ampxtreme/Gruppe-2---Mars-Rover-Challenge/Software/Test/README.md

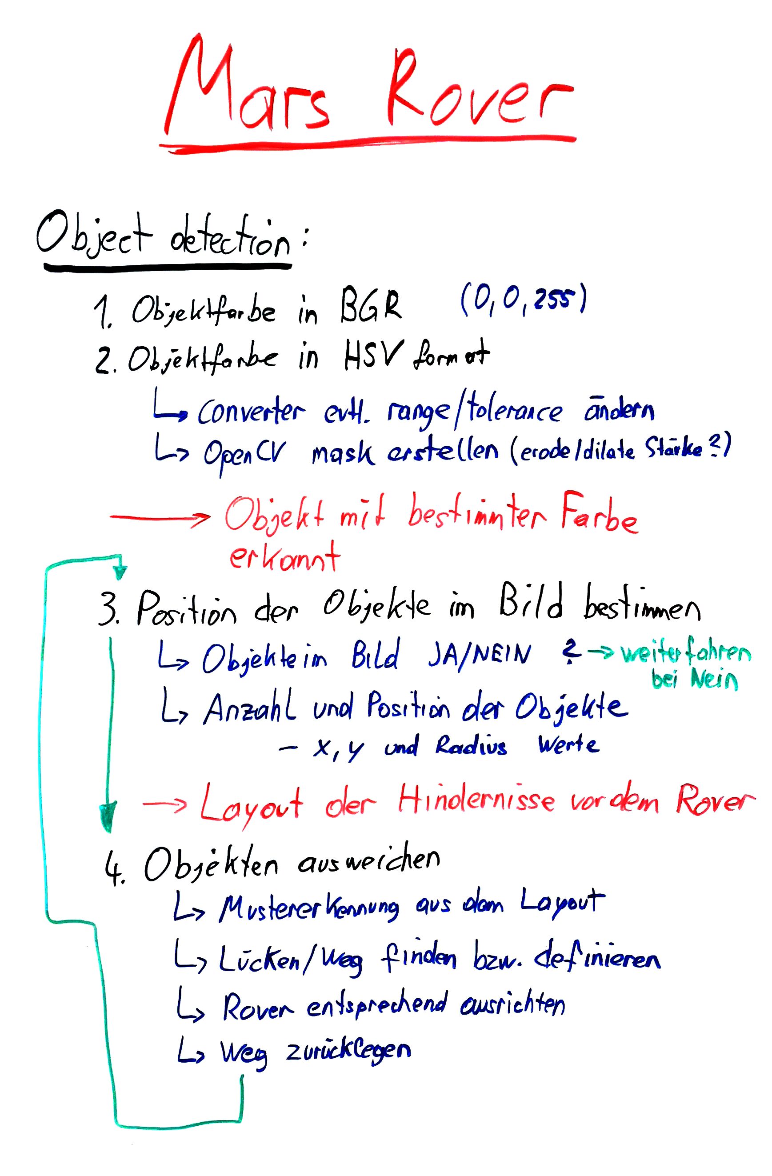
[picture p1: Software/Objekterkennung/objekterkennung_programm.jpg]
Objekterkennung Programmaufbau
