ampxtreme/Gruppe-2---Mars-Rover-Challenge/Dokumentation/Bilder/20190126_115140.jpg

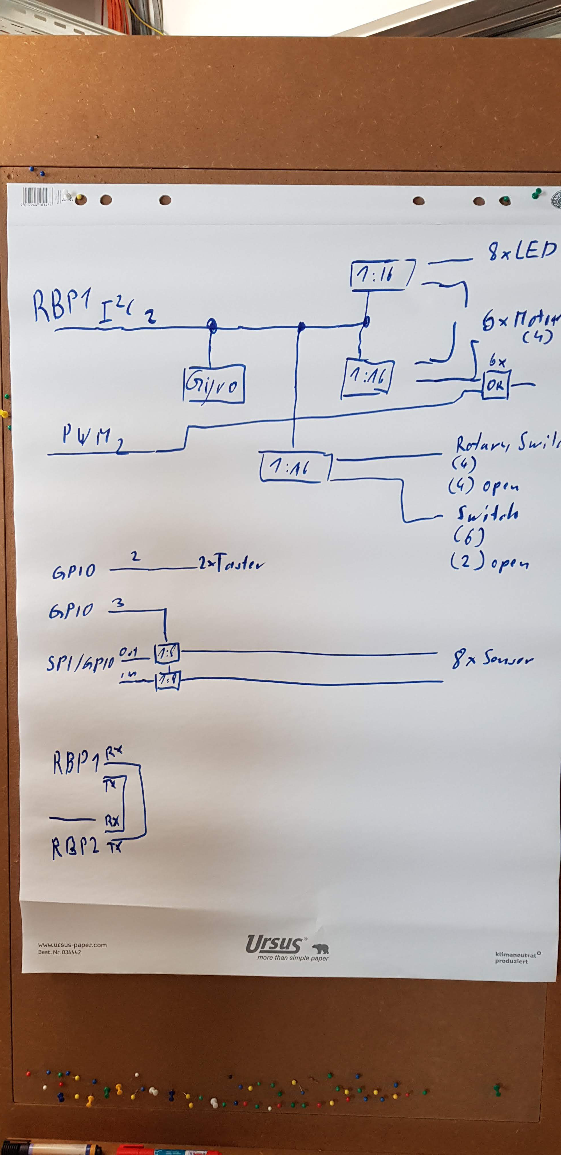
Dokumentation/Bilder/20190126_115140.jpg
