ampxtreme/Gruppe-2---Mars-Rover-Challenge/Dokumentation/Bilder/IMG-20190121-WA0004.jpg

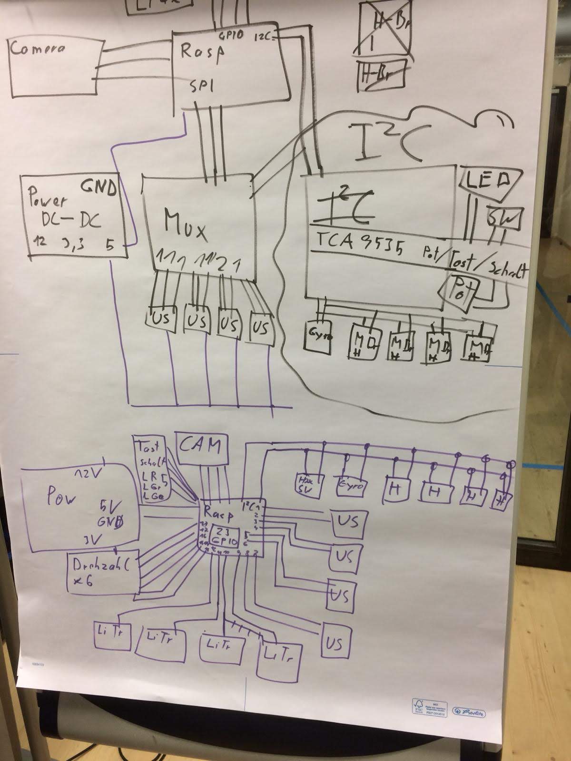
Dokumentation/Bilder/IMG-20190121-WA0004.jpg
