ampxtreme/Gruppe-2---Mars-Rover-Challenge/(threads)

Thread 1 (2019-01-21):

Positionen der Sensoren noch nicht bekannt

ampxtreme, 2019-01-21:

fabioaufinger, 2019-01-22:
Würde vorschlagen 3x Ultraschall vorne am Gehäuse (mitte und schräg links/rechts), vielleicht 1x Ultraschall hinten mittig.
Die Linetracker müssen wir an irgendeiner Achse nach innen bei den Reifen anbringen oder ähnlich (müssen nahe am Boden sein)
Kamera kommt vorne ans Gehäuse

JoeUniv, 2019-01-22:
Bei den Linetrackern müssen wir aber beachten das wir nicht wissen wo die Linien verlaufen, wenn die alle eher mittig vom track sind und unsere sensoren außen auf den Achsen dann steht unser Fahrzeug zur hälfte nach draußen.

ampxtreme, 2019-01-22:
> Bei den Linetrackern müssen wir aber beachten das wir nicht wissen wo die Linien verlaufen, wenn die alle eher mittig vom track sind und unsere sensoren außen auf den Achsen dann steht unser Fahrzeug zur hälfte nach draußen.

Du meinst wenn wir die LT eher an den Rädern anbringen stehen wir rechts oder links zu weit raus und werden dann bespritzt?

mausausdruck1, 2019-01-22:
Vielleicht müssen wir die Achsen nach innen etwas verlängern für die Tracker. Ansonsten seh ich die Sensoren wie @fabioaufinger.

hs123xyz, 2019-01-22:
mir fällt auf, dass wir auch die line tracker evtl. nochmal zusätzlich vor Wasser schützen müssten mit einer Abdeckung oder ähnlichem

Eli93TRO, 2019-01-22:
Schrumpfschlauch?

JoeUniv, 2019-01-23:
plus Heißklebe pistole

JoeUniv, 2019-01-25:
Linetracker mechanisch zentral herunter lassen

JoeUniv, 2019-01-25:
Linetracking über die Kamera

JoeUniv, 2019-01-25:
BRÜCKENKURS:
Linetracker an  Fahrwerk anbringen um zu wissen ob ein Reifen in der Luft hängt oder Bodenkontakt hat.

Closed 2019-01-29.

Thread 3 (2019-01-21):

Gehäusegröße für Platine & Raspberry-Pi sowie ggf. Akku noch nicht bekannt.

ampxtreme, 2019-01-21:
Johannes und ich benötigen die verfügbare Gehäusegröße für die Platine + Raspberry Pi, wobei unser Platzbedarf ungefähr der Größe von ~Raspberry Pi entsprechen (2x Raspb. + 1x Platine).

ampxtreme, 2019-01-22:
ungeführ brauchen wir 12cm breite und 17cm länge platz.
Batterien verstauen wir unter der Platine und den beiden Raspberries.
Ich lade euch noch eine skizze hoch.

JoeUniv, 2019-01-22:
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

JoeUniv, 2019-01-22:
Die Länge eher mit 20cm rechnen.
Günther meinte das die Batterie und was sonst noch so anfällt darunter genügend platz hat.

Eli93TRO, 2019-01-22:
Habe das gezeichnete gerade raufgeladen.
der Platz für die gesamte Elektronik ist 180*150*h35mm

Closed 2019-01-22.

Thread 4 (2019-01-21):

Schutz gegen Spritzwasser der el. Komponenten sicherstellen

ampxtreme, 2019-01-21:

spsmichi, 2019-01-21:
Heißkleber auf die betroffenen Stellen. War auch die Idee vom Günter.

ampxtreme, 2019-01-22:
Jo, das ist sehr gut. Das Gehäuse könnte ggf. von unten ein zwei kleine Löcher/Schlitze erhalten damit ein wenig Luft zirkulieren kann. Zumindest 100% Luftdicht sollten wir es nicht bauen.

Als Vorschlag zur Öffnung des Gehäuses: Öffnung seitlich mit einer Klappe welche sich einfach durch Steckverbindungen abnehmen lässt. Drüber stülpen wir dann für die Fahr ein leicht größeres Gehäuse (nur ein kleines Stück) für zusätzlichen Schutz.

spsmichi, 2019-01-22:
die steckverbindung ist wieder ein kritisches teil. wird es wirklich zu heiß?

Eli93TRO, 2019-01-22:
Laut Günther ist die Hitze überhaupt kein Problem

ampxtreme, 2019-01-22:
> Laut Günther ist die Hitze überhaupt kein Problem

... wenn nicht komplett Luftdicht verschlossen wird ;-)

Wir müssen halt rigendwie ein bisschen die Wartbarkeit sicherstellen. Ich könnte mir vorstellen, dass für kurze Zeit Spritzwasser auch bei einer Steckverbindung nicht viel passiert wenn sie gut passt. Was meint ihr?

JoeUniv, 2019-01-24:
nachdem die anderen so fest draufspritzen können wie sie wollen würde ich die zu Luft eher von unten Regulieren.
Wie wärs wir denken über eine Konstruktion nach die man auf den Kopf legen muss um sie zu öffnen? -> DIe "Tür" ist auf dem Bauch des Fahrzeugs.

Closed 2019-03-13.

Thread 5 (2019-01-21):

Klebeband für den Reifen

spsmichi, 2019-01-21:
Habe verschiedene Möglichkeiten raus gesucht.

[Uploading Klebeband.docx…]()

spsmichi, 2019-01-21:
[Klebeband.pdf](https://github.com/ampxtreme/Gruppe-2---Mars-Rover-Challenge/files/2780155/Klebeband.pdf)

mausausdruck1, 2019-01-22:
Ich wäre für das Gummi-Band.
Anti-Rutsch ist für die Kombination Gummisole/Band sicher gut, aber unser System wäre dann Holzplatte/Antirutschband.

fabioaufinger, 2019-01-22:
Und wenn wir einfach Gummibänder um die Lauffläche spannen?

JoeUniv, 2019-01-22:
meinst du damit Gummiringerl?
Das könnte funktionieren

ampxtreme, 2019-01-22:
Die dürften dann halt nicht stark gespannt sein, außerdem müssen wir bedenken, dass es uns die beim "Drehen" runterziehen kann.

Ich wäre auch für das Gummi-Klebeband, hätte allerdings noch einen Vorschlag, da ich das im Auto habe und weiß das es gut funktioniert:

https://www.amazon.de/Filmer-37119-Antirutschmatte-120-zuschneidbar/dp/B004U5WXRY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

JoeUniv, 2019-01-22:
müsste man probieren, könnte mir vorstellen das die gummiringerl auch gespannt eine gute reibung haben.
Auf jeden Fall um einiges besser als die Reifen die wir getestet haben.
Das Klebeband ist aber auch nicht viel komplexer umzusetzen.

spsmichi, 2019-01-22:
@ampxtreme das ist nich selbstklebend oder?

Ich bestelle das gummiklebeband und zusätzlich normale gummis.

Closed 2019-01-22.

Thread 10 (2019-01-22):

Poster von Tag 1

mausausdruck1, 2019-01-22:
Hat jemand die Poster fotographiert und kann die ins Projektwiki oder sonstwohin tun? Wäre cool. Oder gibt es die noch irgendwo?

ampxtreme, 2019-01-22:
Das hier? https://photos.app.goo.gl/zjZwxRgjmU4h8CiR8

mausausdruck1, 2019-01-23:
Top, schon einmal eines. Gibts die anderen auch noch?

ampxtreme, 2019-01-23:
Ich habe sonst nur das hier: https://photos.app.goo.gl/zbxsqBhPGwhCcMCr8

Closed 2019-01-28.

Thread 7 (2019-01-22):

Verhalten der Linetracker bei nassem Untergrund

ampxtreme, 2019-01-22:
Das Verhalten der LT-Sensoren bei nassem Untergrund auf einer schwarzen Linie ist mir unklar. Ich werde das heute mal mit einem schwarzen Mauspad testen.

ampxtreme, 2019-01-22:
Habe es getestet auf einem schwarzen Mauspad. Kein Unterschied festzustellen. Ich schließe das Thema, wir sollten das aber kommende Woche einmal probieren.

Closed 2019-01-22.

Thread 9 (2019-01-22):

Test-Verkabelung

mausausdruck1, 2019-01-22:
Hallo Zusammen,

können wir für Samstag eine Test Verkabelung mal einpeilen? Das würde sehr bei der SW-Entwicklung helfen.
1) Sensoren
2) Motoren idealerweise über diese neue  I2C H-Brücke. Kann man die bis Samstag organisieren? Wer macht das?

Andere Vorschläge?

JoeUniv, 2019-01-23:
Habe zu den einzelnen teilen die wir benötigen ein eigenes Issue erstellt -> Siehe Elektronik

Closed 2019-01-28.

Thread 11 (2019-01-23):

Elektronik

JoeUniv, 2019-01-23:
Da wir am Samstag die Elektronik testen müssen sollten wir am Freitag alle Sensoren etz. aus der Uni mitnehmen.

Wir brauchen:
- 6x Drehzalmesser (LM393)
- 4x Ultraschall (HC-SR04)
- 4x Linetracker(KY - 033)
- 1x Cam
- Gyro( MPU6000 oder MPU6050)(im Notfall MPU9250)
- 4x H-Brücke (DRV8847)
- Raspberry Pi 3
- I2C
- Rotary Switch

Sollte euch noch was einfallen, bitte anfügen!!!

JoeUniv, 2019-01-23:
- Pins
- Kabel
- Steckplatine

mausausdruck1, 2019-01-23:
Ich bin mir nicht sicher, ob die H Brücken da herum liegen, die hat der Udo (?) uns ja empfohlen. Die wären aber wichtig!

Closed 2019-01-29.

Thread 13 (2019-01-25):

Abstrahlung Winkel der Ultraschallsensoren

JoeUniv, 2019-01-25:

ampxtreme, 2019-01-29:
Nach kurzem Test sollte dies kein Problem sein. Wird geschlossen.

Closed 2019-01-29.
