ampxtreme/Gruppe-2---Mars-Rover-Challenge/Rover_PCB_2019-02-01.pdf

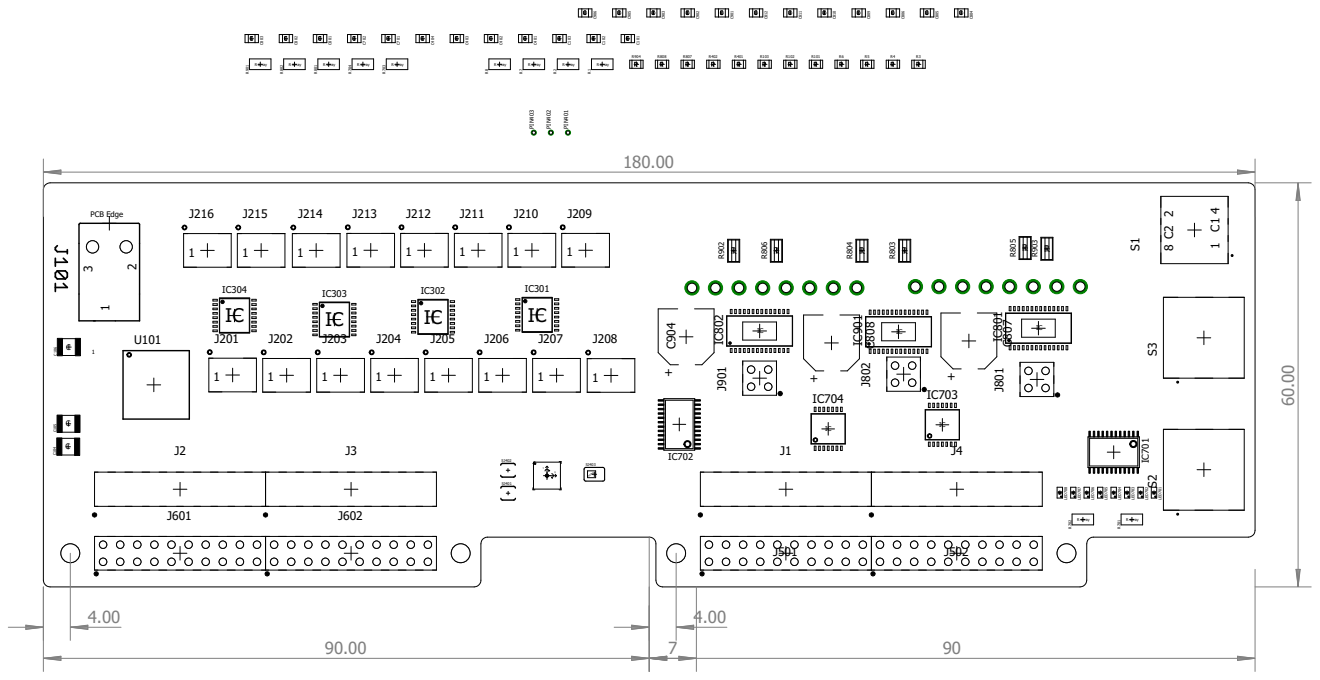
[picture p4: page 1]
