ampxtreme/Gruppe-2---Mars-Rover-Challenge/(commit log)

2019-01-19 Create material.txt
    Materialsammlung
2019-01-22 Update 1
    Sortiert und erweitert. Ggf. fehlen noch Teile. Li
2019-01-22 Add files via upload
    Das ist der Deckel der Elektronik-Schachtel
    [Deckel mit Ösen.SLDPRT]
2019-03-30 Create LEDs Data
