ampxtreme/Gruppe-2---Mars-Rover-Challenge/(notices)

Notices in the files:
parts and their libraries:
Rover_bib: Created A. Bachmaier, K&K Prime Engineering GmbH (c) 2011
